GunCHimSaK/self_balancing/hardware/interface_pcb/production/bom.csv

Designator | Footprint | Quantity | Value | LCSC Part #
BT1 | BarrelJack_Horizontal | 1 | 12v
C1 | 0805 | 1 | 10uF
C2 | 0805 | 1 | 22uF
C3 | 0805 | 1 | 100uF
D1 | D_SOD-123 | 1 | D
J1 | PinSocket_1x04_P2.54mm_Vertical | 1 | Conn_01x04_Socket
J2 | PinSocket_1x04_P2.54mm_Vertical | 1 | Conn_01x04_Pin
J4, J6 | PinSocket_1x08_P2.54mm_Vertical | 2 | Conn_01x08_Socket
R1, R2, R3, R4 | 0805 | 4 | 10k
SW1_2, SW2, SW3, SW4 | SW_PUSH_6mm | 4 | SW_Push
SW1 | SW-TH_SS11-BBIWQ-XX | 1 | SW_SPST
U1 | SOT-223-3_TabPin2 | 1 | AMS1117-3.3
