GunCHimSaK/self_balancing/hardware/interface_pcb/Interface_pcb.kicad_pcb

## KiCad design hardware/interface_pcb/Interface_pcb.kicad_pcb (2026-11-08)

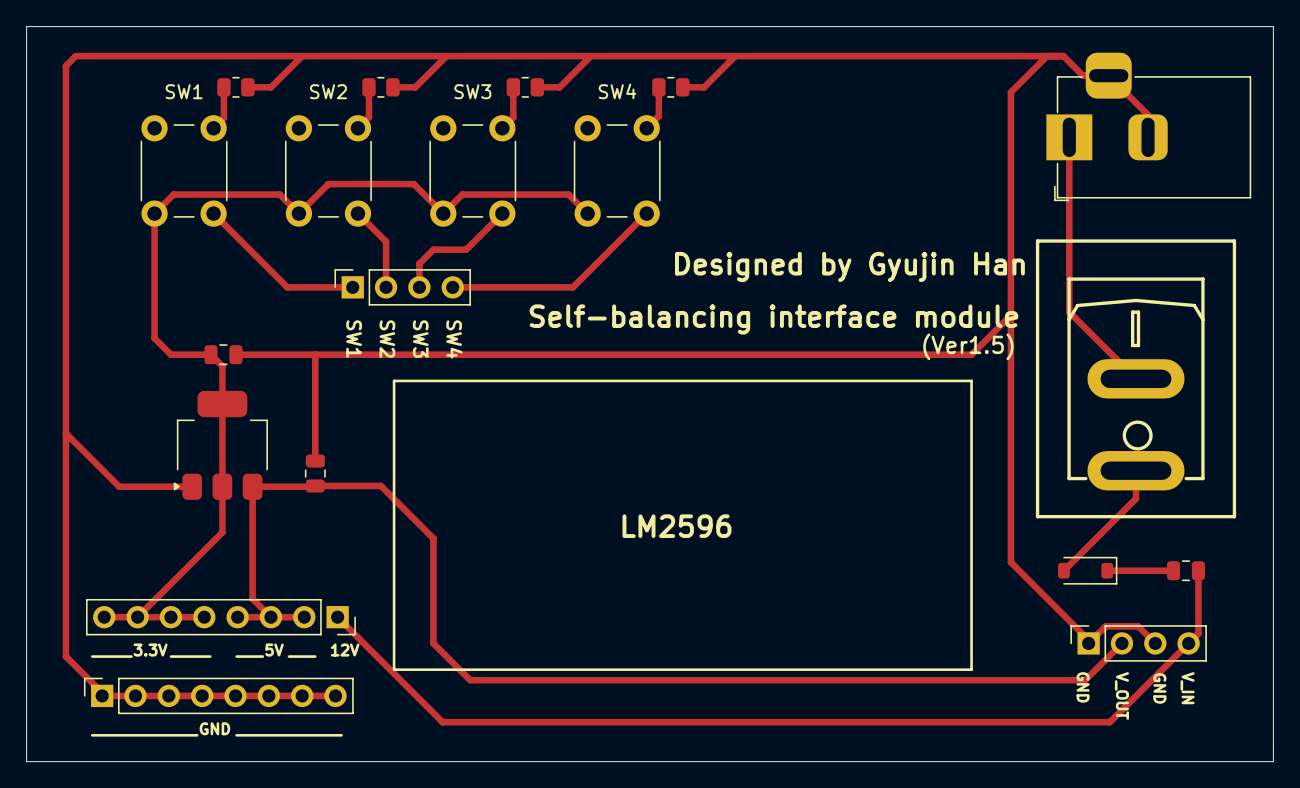
[picture p1: board Interface_pcb.kicad_pcb from above]

Board: 2 copper layers, 95.0 x 56.0 mm, 19 parts (0 on the bottom side), 11 nets.

Parts:
BT1: 12v; BarrelJack_Horizontal
C1: 10uF; C_0805_2012Metric
C2: 22uF; C_0805_2012Metric
C3: 100uF; C_0805_2012Metric
D1: D; D_SOD-123
J1: Conn_01x04_Socket; PinSocket_1x04_P2.54mm_Vertical
J2: Conn_01x04_Pin; PinSocket_1x04_P2.54mm_Vertical
J4, J6: Conn_01x08_Socket; PinSocket_1x08_P2.54mm_Vertical
R1, R2, R3, R4: 10k; R_0805_2012Metric
SW1, SW2, SW3, SW4: SW_Push; SW_PUSH_6mm
SW1#2: SW_SPST; SW-TH_SS11-BBIWQ-XX
U1: AMS1117-3.3; SOT-223-3_TabPin2

Connections:
unnamed: BT1.1 (+), SW1#2.2 (B)
unnamed: BT1.2 (-), BT1.3, C1.2, C2.2, J1.1, J1.3, J6.1, J6.2, J6.3, J6.4, J6.5, J6.6, J6.7, J6.8, R1.1, R2.1, R3.1, R4.1, U1.1 (GND)
unnamed: D1.2 (A), SW1#2.1 (A)
unnamed: C3.2, D1.1 (K)
unnamed: C1.1, J1.2, J4.2, J4.3, J4.4, U1.3 (VI)
unnamed: C3.1, J1.4, J4.1
unnamed: J2.1, R1.2, SW1.1
unnamed: J2.2, R2.2, SW2.1
unnamed: J2.3, R3.2, SW3.1
unnamed: J2.4, R4.2, SW4.1
unnamed: C2.1, J4.5, J4.6, J4.7, J4.8, SW1.2, SW2.2, SW3.2, SW4.2, U1.2 (VO)
