GunCHimSaK/self_balancing/(commit log)

2026-11-08 Organize project: README, pin map, CubeMX pin-only ioc, interface PCB, CAN test code, DMP IMU driver
    [Interface_pcb.kicad_pcb, Interface_pcb.kicad_sch, bom.csv, designators.csv, positions.csv]
2026-11-08 Update to final firmware (F446RE, BNO055, cascade PID), keep version history, add development log and F446RE pin map
2026-11-08 Add PCB troubleshooting: decoupling capacitor placement and missing connector GND
